palmerr23/SwissArmyKnife/TestController/README.md

The device file goes into the devices folder wherever TestController is installed

The help file goes into your documents/TestController/Settings folder (Windows)

TestController https://lygte-info.dk/project/TestControllerIntro%20UK.html
