palmerr23/SwissArmyKnife/OTA-test/readMe.txt

The DATA folder here is a copy of the main program's DATA folder.
