palmerr23/SwissArmyKnife/(threads)

Thread 1 (2023-04-25):

Compiling code from source fails

ms-mtbkr, 2023-04-25:
Hi Richard,
  Beautiful project. I have two boards with all of the surface mount components, and DIL connectors installed. Ready for a few basic tests, but I can't get the first version of the software to build. I have a working Arduino environment newly installed, and have imported the '.zip' SwissArmy project directory. It looks like this is an earlier version before going to an OTA version? There appear to be filename differences, eg SwissArmy.ino has '#include "mySCPI_relay.h"' where the filename is 'mySCPI_Relay.h'. Also, the list of libraries that need to be installed has to be updated, eg "MCP45HVX1" and others. Could you have a look please? Also, is there any project discussion around this? You might curate a thread on EEVBlog.
Regards,
Mike

palmerr23, 2023-04-25:
Mike,

Firstly, what OS are you building on - case sensitive file names indicates Linux? The original was built on Windows - sorry for the laxity on filename case.

I'll :
- check the version of the code files - as they may be out of date
- tidy up the names of the include files
- update the list of libraries and add any that aren't easily available.

I'll post again after I've done these things.

Have you tried the files in the download link supplied in the Silicon Chip article?

As for OTA, that's independent of the code - simply another way to upload a .bin file to the ESP32.

Also, if you have Arduino 2.0 installed, you'll need a utility to upload the data files, as this is only available (so far) in Arduino 1.x.

If you don't have access to something else, my OTA + file manager utility is at https://github.com/palmerr23/ESP32-OTA-and-File-Manager

ms-mtbkr, 2023-04-25:
Thanks for your prompt  reply. Yes, I am running Linux, and a 2.0 series Arduino. I did try files from the Silicon Chip website, but the code looks the same. Also,  I have been playing with the file names, and installing libraries. After fixing the obvious, I tried installing ESPASyncWebSrv by dvarrel (a guess),  I think the code includes ESPASyncWebServer.h. Then I got "mySHTML_processor.h:147:202: error: 'FMAX' was not declared in this scope". When you do a revision, I'll try again from a clean build.
  This is an extraordinary design, and I think it will be very popular, which unfortunately also means some teething issues.

palmerr23, 2023-04-26:
The ESPASyncWebSrv library I used is by me-no-dev

https://github.com/me-no-dev/ESPAsyncWebServer

and also requires

https://github.com/me-no-dev/AsyncTCP

Also see the other issue - there's a fault in the PCBs

palmerr23, 2023-04-26:
I've updated
* case of the include files in the .ino file
* list of required libraries

I've also compared the files here with my off-line source and they are up to date

ms-mtbkr, 2023-04-26:
Thank you, I'll give it a go. I'm a github newbie - unsure of the protocols : I close the issue?

I'll look at the PCB issue in a minute. So many questions! KiCAD or something else? Did you put it through assembly?  But, I'm sure you are very busy with this thing now.
Regards,
Mike

palmerr23, 2023-04-26:
I'll close the issue once you've confirmed it works.

Closed 2023-04-26.

Thread 2 (2023-04-26):

PCB fault

palmerr23, 2023-04-26:
ESP32 pins 20-38 are reversed on the PCB.

I will publish a hardware/software fix as soon as I have it

ms-mtbkr, 2023-04-26:
Hi again!
  So :- now may I ask what PCB design package you used? Doesn't SC use Altium?
  Do you intend to  publish any version of the PCB design files?

  How can I help with the project?

  The hand assembly is reasonably difficult, but the project would appeal across the board to anyone interested in analog - ie *real* beginners. But there lies the rub - you need more than beginner skills to build it. My vote is KiCAD, and let the robots do most of the build. Where do you want to take this?

  BTW, I'm new to ESP32 also. If I have to hand-make a harness, that shouldn't be too difficult. But then, I should go directly to my favorite CPU ...  also,
- bigger pads if you want it to be only a hand soldered work of art,
- especially for the yummy miniMELFs (JLCPCB Basic component, as are all of the passives)
- The 5V to +/-15V converter looks like a gem.

palmerr23, 2023-04-26:
Hi,

I'm a KiCAD user, and yes SC uses Altium.

No, SC has the exclusive use of the design files - as the proceeds of their online shop help keep the magazine afloat.

I have the fix in hand, I just want to test it before publishing the solution - part rewiring and part software for the affected pins.

ms-mtbkr, 2023-04-26:
So to clarify, the pin reversal affects one side of the package ... no power supply pins, so having plugged the CPU into it's socket, probably no harm done.
  I'm also using KiCAD.

palmerr23, 2023-04-26:
The CLK pin will have been be grounded when plugged in, which is unlikely to cause damage.

If the ESP still boots when unplugged, then everything's probably OK.

palmerr23, 2023-04-27:
Instructions for correcting the faults on Rev A boards are included on the main page for this project.

Closed 2023-04-27.

Thread 3 (2023-05-09):

Relay control pins reversed

palmerr23, 2023-05-09:
The control pins for relays 1 & 2 were reversed.

This has been corrected in the V2 binary and source code.

palmerr23, 2023-05-09:
As above

Closed 2023-05-09.

Thread 4 (2023-05-09):

Oscillation in op amp

palmerr23, 2023-05-09:
Op amp units A, C & D may oscillate at approximately 1 MHz under some circumstances.

100-270pf capacitors should be added in parallel to R12, R18 and R29.
C17, C18 and C19 have been added to Rev B PCBs

See "Swiss Army Knife Rev A PCB Corrections.pdf"

palmerr23, 2023-05-09:
Corrected in Rev B PCBs

Closed 2023-05-09.
