palmerr23/SwissArmyKnife/(commit log)

2023-04-26 Fixed include filename case
    [SwissArmy.ino]
2023-05-09 reversed pins for relays
    [SwissArmy.ino]
2023-05-09 Added relay connection reversal
